seblovett/RGB_Clock/README.md

RGB_Clock
=========

A LED Clock

A contained PCB clock, with 60 RGB LEDs to display the time. 

Includes a noise sensor, LDR to adjust the brightness.
