seblovett/RGB_Clock/Schematics/SMPS_Design.ods

Sheet: Sheet1
Device | Voltage | Current | Count | Power
Atxmega | 3.3 | 1.50E-002 | 1 | 0.0495
LEDs | 3.3 | 0.1 | 60 | 19.8
PWM Controller | 3.3 | 1.00E-002 | 12 | 0.396
LM324 | 3.3 |  | 1 | 0
 |  |  |  | 20.2455
 |  |  |  | 4.0491

Sheet: Sheet2
Datasheet Constants
Vsw(bot) | 1.80E-01
t(on)(min) | 6.00E-08
Vsw(top) | 4.00E-01
t(off)(min) | 1.20E-07
Input
Vin min | 4.1734345909
Vin nom | 5
Vin max | 12
Output
Vout | 3.298
Iout (max) | 6
Iout (nom)
Feedback
Target Vout | 3.3
R2 | 1.00E+06
Target R1 | 2.40E+06
R1 | 2.40E+06
Vout | 3.298
Switching Frequency
Target Fsw | 1.00E+06
Rt (target) | 4.13E+01 | kOhm
Rt (actual) | 4.12E+01
Actual Fsw | 1.00E+06
Fsw(max) | 1.21E+07
Inductor
L(target) | 2.43E-06
Sx | 2.00E+05
L(min) | 2.34E-05
L(actual) | 3.20E-06
Ripple Current | 7.46E-01
Duty Cycle | 0.6596
Brown Out
Vin(en)(target) | 4.5
R4 | 1.00E+005
R3(target) | 3.50E+005
R3 | 3.50E+005
Vin(en) | 4.5
