seblovett/RGB_Clock/cad/Clock_Face.png

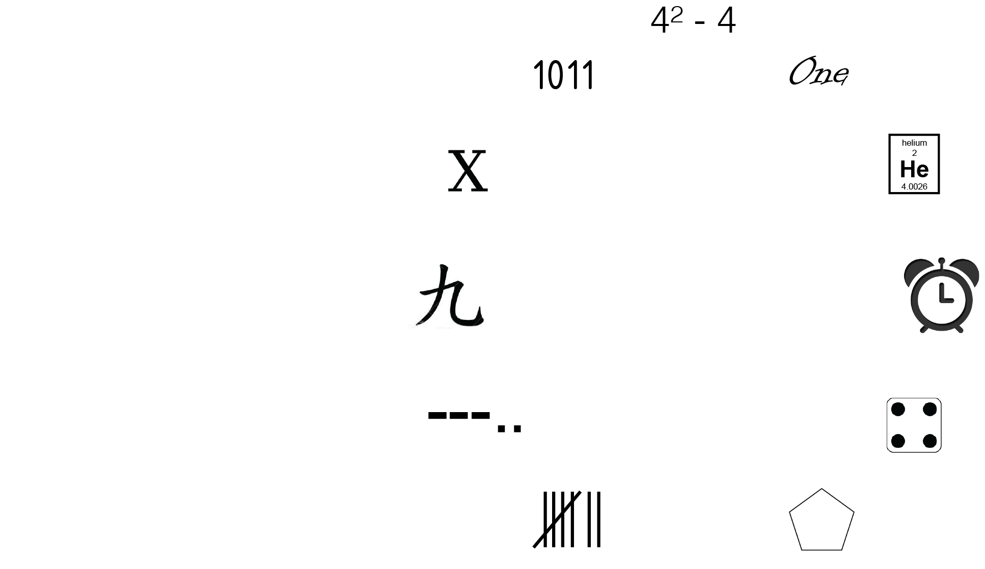
cad/Clock_Face.png
