seblovett/RGB_Clock/Schematics/BoM.ods

Reference | Value | Footprint | Datasheet | Part | Supplier |  | Price
CON2 | BARREL_JACK | Connect:JACK_ALIM | http://dlnmh9ip6v2uc.cloudfront.net/datasheets/Prototyping/18742.pdf | PRT-10811 | Farnell | 1 | 0.6 | 0.6
CON1 | USB-MICRO-B | Connect:USB_Mini-B |  |  | Stock | 1 |  | 0
X1 | 16MHz | Crystals_Oscillators_SMD:crystal_FA238-TSX3225 | http://www.farnell.com/datasheets/97450.pdf | ABM8-16.000MHZ-B2-T | Farnell | 1 | 1.25 | 1.25
IC1 | ATXMEGA256A3BU-A | Housings_QFP:TQFP-64_14x14mm_Pitch0.8mm |  | ATXMEGA256A3BU-A | Farnell | 1 | 5.41 | 5.41
U3 | PCA9685 | Housings_SSOP:TSSOP-28_4.4x9.7mm_Pitch0.65mm |  |  | Farnell | 12 | 1.34 | 16.08
D1 | LED | LEDs:LED-1206 |  |  | Farnell | 1 | 0.059 | 0.059
U13 | LT8612 | rgb:28QFN |  |  | LT | 1 |  | 0
BT1 | 3V | rgb:BU2032SM-HD-GTR-ND | http://www.memoryprotectiondevices.com/datasheets/BU2032SM-HD-G-datasheet.pdf | BU2032SM-HD-GTR-ND | Digikey | 1 | 0.59 | 0.59
J1 | AVR_JTAG_Header | rgb:FTSH-105-01-L-DV-K-A-P |  | FTSH-105-01-L-DV-K-A-P | Farnell | 1 | 1.41 | 1.41
LED11 | LED_RGB | rgb:rgbled1 |  | ASMT-YTD7-0AA02 | Farnell | 60 | 0.276 | 16.56
L1 | 3.2u | rgb:SD43 | http://www.coilcraft.com/pdfs/sd43.pdf | SD43-332ML | Coilcraft | 1 | 0.65 | 0.65
X2 | 32.768KhZ | rgb:SMD_Osc | http://www.abracon.com/Resonators/ABS06.pdf | ABS06-32.768KHZ-1-T | Farnell | 1 | 1.85 | 1.85
P1 | CONN_02X08 | Socket_Strips:Socket_Strip_Straight_2x08 |  |  | Stock | 1 |  | 0
SW1 | SW_PUSH |  | http://www.newark.com/pdfs/datasheets/spc/Ta-1143.pdf | MC32882 | Farnell | 4 | 0.173 | 0.692
 | PCB |  |  |  |  | 10 |  | 27
 |  |  |  | 37.41
 |  |  |  | 17.25 |  | 478.51
