seblovett/RGB_Clock/cad/jtag2.stl

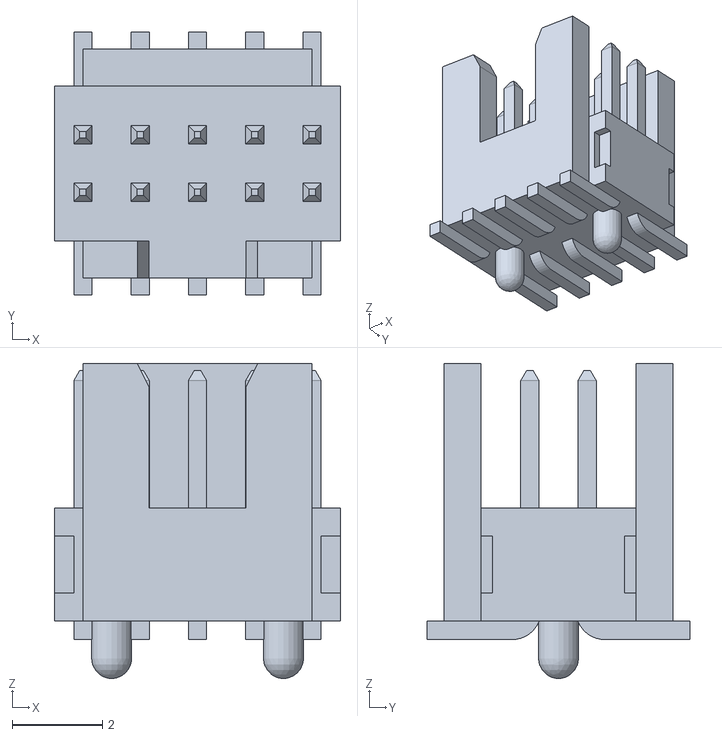
[picture p2: CAD file, 2015-01-14]
cad/jtag2.stl
6.35 x 5.84 x 6.99
