seblovett/RGB_Clock/cad/microusb2.stl

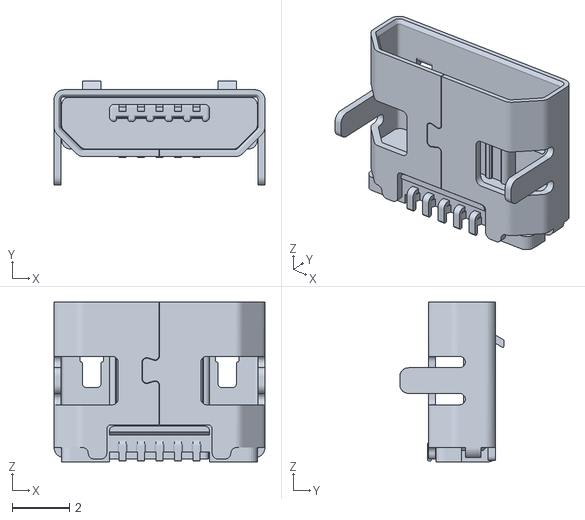
[picture p3: CAD file, 2015-01-14]
cad/microusb2.stl
7.40 x 3.66 x 5.60
