seblovett/RGB_Clock/cad/bu2032sm-hd-g_component.stl

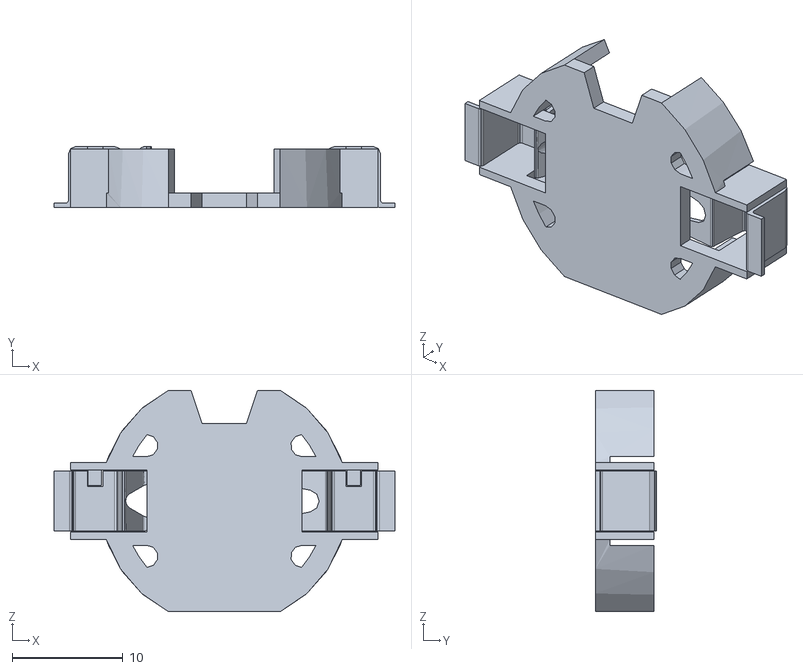
[picture p4: CAD file, 2015-01-14]
cad/bu2032sm-hd-g_component.stl
30.8 x 5.53 x 20.0
