seblovett/RGB_Clock/cad/rgb2.stl.stl

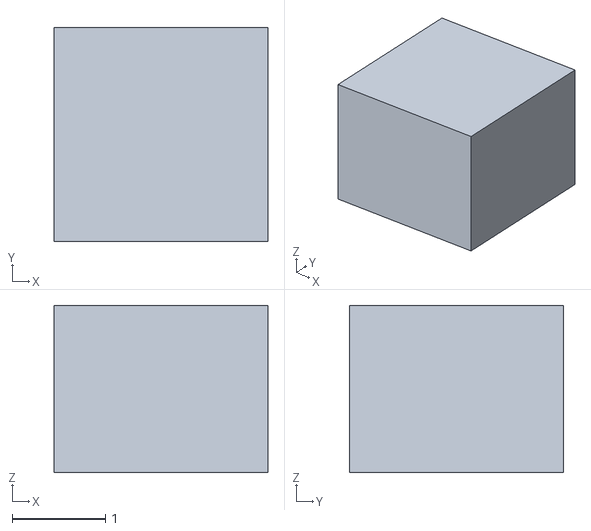
[picture p5: CAD file, 2015-01-14]
cad/rgb2.stl.stl
2.30 x 2.30 x 1.80
