seblovett/RGB_Clock/cad/rgb2.stl

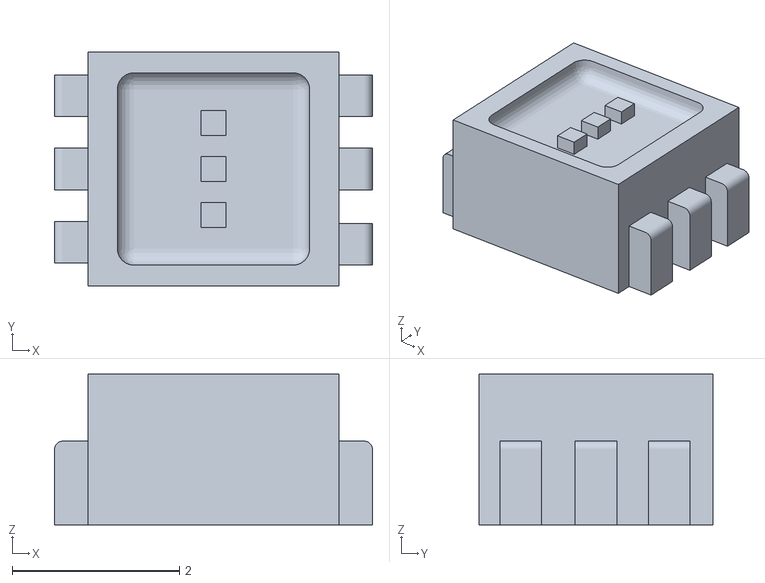
[picture p6: CAD file, 2015-01-10]
cad/rgb2.stl
3.80 x 2.80 x 1.80
