seblovett/RGB_Clock/(list of files, cad)

Other CAD files:
cad/jtag.fcstd
cad/batt.stl
cad/batt2.stl.stl
cad/microusb.stl
cad/RGBLED.fcstd
cad/rgb.stl
cad/jtag.stl
