seblovett/RGB_Clock/(threads)

Thread 3 (2015-01-28):

Add Power In connector

seblovett, 2015-01-28:
Add a power in connector and circuitry. Power in for voltages higher than 5V for more current

Closed 2015-01-28.

Thread 7 (2015-01-28):

Interface

seblovett, 2015-01-28:
Add some form of interface.
Capacitive sensors would be ideal, but KiCAD doesn't currently support arbitrary copper shapes. Some simple tac buttons will have to suffice.

Closed 2015-01-28.

Thread 8 (2015-02-08):

Reroute I2C

seblovett, 2015-02-08:
Re route I2C nets to closer to the edge. This is to improve the ground return path from the LED drivers.

Closed 2015-02-09.
