seblovett/RGB_Clock/Schematics/Display_Sub.kicad_pcb

## KiCad design Schematics/Display_Sub.kicad_pcb (2015-04-05)

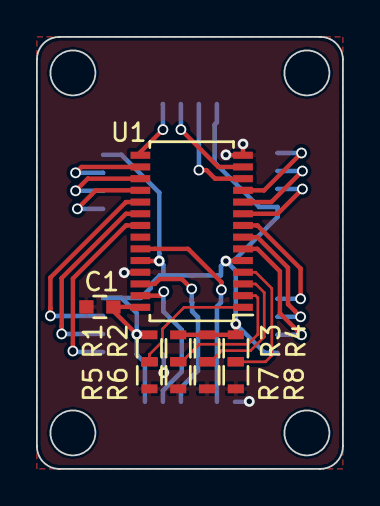
[picture p7: board Display_Sub.kicad_pcb from above]

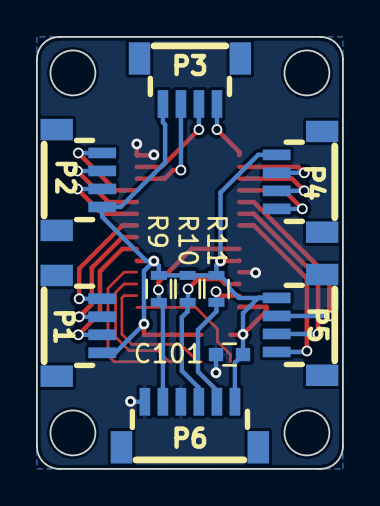
[picture p8: board Display_Sub.kicad_pcb from below]

Board: 2 copper layers, 17.0 x 24.0 mm, 20 parts (10 on the bottom side), 24 nets.

Parts:
C1, C101: C; C_0603
P1, P2, P3, P4, P5: CONN_01X04; JST-BM-04B-SRSS-TB
P6: CONN_01X06; JST-BM-06B-SRSS-TB
R1, R2, R3, R4, R5, R6, R7, R8: 0R; R_0603
R9, R10, R11: 10k; R_0603
U1: PCA9685; TSSOP-28_4.4x9.7mm_Pitch0.65mm

Connections:
/ID0: R1.2, R5.1, U1.1
/ID1: R2.2, R6.1, U1.2
/ID2: R3.2, R7.1, U1.3
/ID3: R4.2, R8.1, U1.4
/SCL: P6.3, R10.2, U1.26
/SDA: P6.2, R11.2, U1.27
/~OE: P6.5, R9.2, U1.23
GND: C1.2, C101.2, P6.4, P6.6, R5.2, R6.2, R7.2, R8.2, U1.14, U1.25
unnamed: P1.2, U1.6
unnamed: P1.3, U1.7
unnamed: P1.4, U1.8
unnamed: P2.2, U1.9
unnamed: P2.3, U1.10
unnamed: P2.4, U1.11
unnamed: P3.2, U1.12
unnamed: P3.3, U1.13
unnamed: P3.4, U1.15
unnamed: P4.2, U1.16
unnamed: P4.3, U1.17
unnamed: P4.4, U1.18
unnamed: P5.2, U1.19
unnamed: P5.3, U1.20
unnamed: P5.4, U1.21
VPP: C1.1, C101.1, P1.1, P2.1, P3.1, P4.1, P5.1, P6.1, R1.1, R2.1, R3.1, R4.1, R9.1, R10.1, R11.1, U1.5, U1.24, U1.28
