seblovett/RGB_Clock/Schematics/Root.kicad_pcb

## KiCad design Schematics/Root.kicad_pcb (2015-04-05)

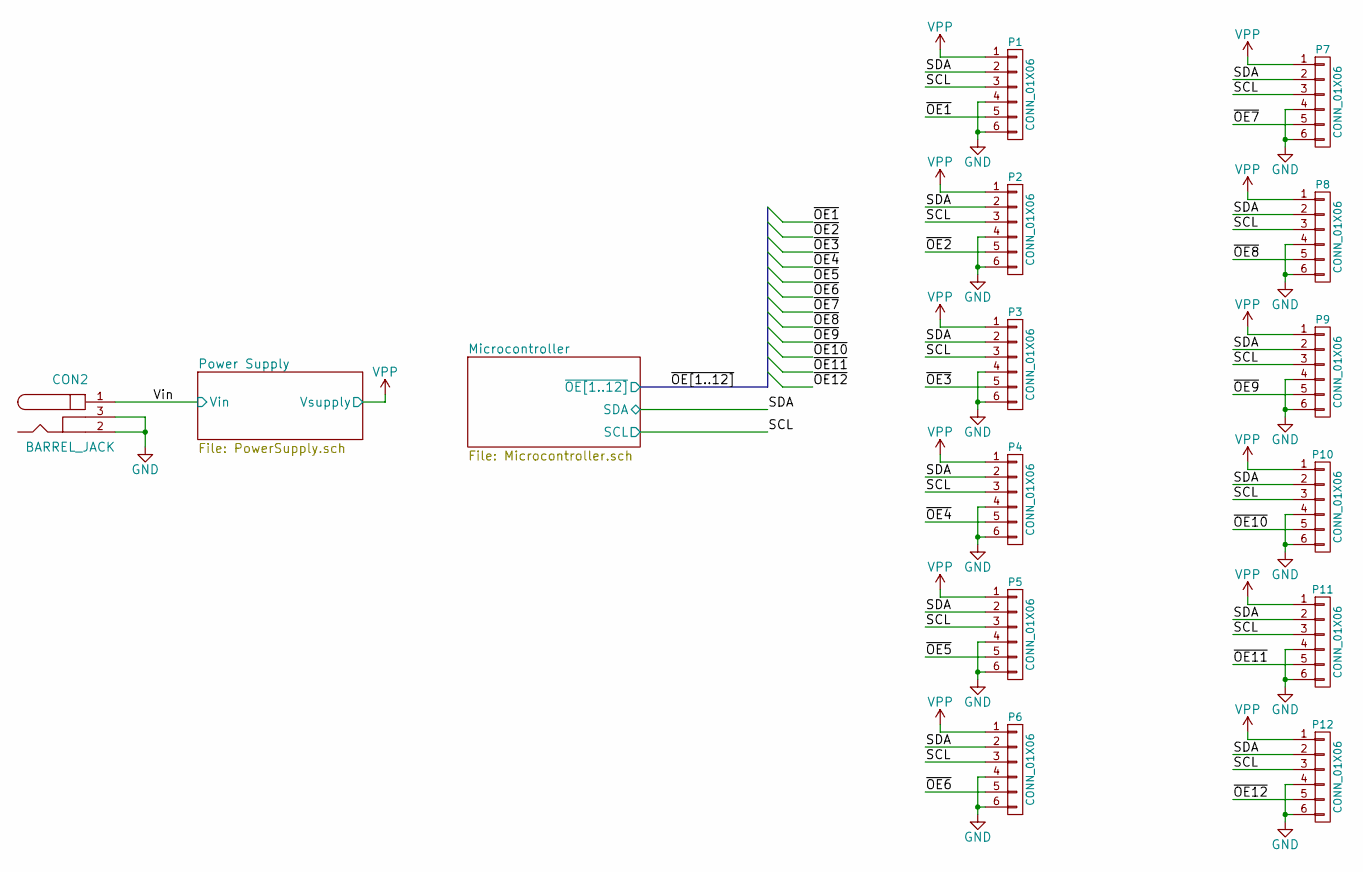
[picture p9: schematic Root.sch, RGB Clock]

Parts:
CON2: BARREL_JACK; JACK_ALIM; Part PRT-10811
P1, P2, P3, P4, P5, P6, P7, P8, P9, P10, P11, P12: CONN_01X06

Connections:
/Microcontroller/SCL: P1.3, P2.3, P3.3, P4.3, P5.3, P6.3, P7.3, P8.3, P9.3, P10.3, P11.3, P12.3; also elsewhere on the board
/Microcontroller/SDA: P1.2, P2.2, P3.2, P4.2, P5.2, P6.2, P7.2, P8.2, P9.2, P10.2, P11.2, P12.2; also elsewhere on the board
/Power Supply/Vin: CON2.1; also elsewhere on the board
/~OE1: P1.5; also elsewhere on the board
/~OE2: P2.5; also elsewhere on the board
/~OE3: P3.5; also elsewhere on the board
/~OE4: P4.5; also elsewhere on the board
/~OE5: P5.5; also elsewhere on the board
/~OE6: P6.5; also elsewhere on the board
/~OE7: P7.5; also elsewhere on the board
/~OE8: P8.5; also elsewhere on the board
/~OE9: P9.5; also elsewhere on the board
/~OE10: P10.5; also elsewhere on the board
/~OE11: P11.5; also elsewhere on the board
/~OE12: P12.5; also elsewhere on the board
GND: CON2.2, CON2.3, P1.4, P1.6, P2.4, P2.6, P3.4, P3.6, P4.4, P4.6, P5.4, P5.6, P6.4, P6.6, P7.4, P7.6, P8.4, P8.6, P9.4, P9.6, P10.4, P10.6, P11.4, P11.6, P12.4, P12.6; also elsewhere on the board
VPP: P1.1, P2.1, P3.1, P4.1, P5.1, P6.1, P7.1, P8.1, P9.1, P10.1, P11.1, P12.1; also elsewhere on the board

Schematic: Microcontroller.sch

Parts:
BT1: 3V; BU2032SM-HD-GTR-ND; Part BU2032SM-HD-GTR-ND
C10, C12: 33pF; C_0603
C11, C13: 22pF; C_0603
C14: 1u; C_0603
C15, C16, C17, C18, C19: 100n; C_0603
CON1: USB-MICRO-B; USB_Mini-B
IC1: ATXMEGA256A3BU-A; TQFP-64_14x14mm_Pitch0.8mm; Part ATXMEGA256A3BU-A
J1: AVR_JTAG_Header; FTSH-105-01-L-DV-K-A-P; Part FTSH-105-01-L-DV-K-A-P
JP1, JP2, JP3: JUMPER; R_0603
P13, P14: CONN_01X02; Pin_Header_Straight_1x02
R15: 100R; R_0603
R17, R18: 47k; R_0603
R100: 100k; R_0603
SW1, SW2: SW_PUSH; SW; Part MC32882
X1: 16MHz; crystal_FA238-TSX3225; Part ABM8-16.000MHZ-B2-T
X2: 32.768KhZ; SMD_Osc; Part ABS06-32.768KHZ-1-T

Connections:
/Microcontroller/AVR_RXD: IC1.22 (MISO/RXD1/~OC0DLS~/PC6), P14.1
/Microcontroller/AVR_TXD: IC1.23 (EVOUT/CLKP/SCK/TXD1/OC0DHS/PC7), P14.2
/Microcontroller/JUMPER: IC1.38 (PE2/OC0C/RXD0), JP1.1, R100.2
/Microcontroller/SCL: IC1.17 (SCL/XCK0/OC0AHS/OC0B/PC1), R18.2; also elsewhere on the board
/Microcontroller/SDA: IC1.16 (SDA/~OC0ALS~/OC0A/PC0), R17.2; also elsewhere on the board
/Microcontroller/SW1: IC1.18 (SDAOUT/RXD0/~OC0BLS~/OC0C/PC2), SW1.1
/Microcontroller/SW2: IC1.1 (AC3/ADC11/ADC3/PA3), JP3.1
/Microcontroller/TCK: IC1.12 (TCK/AC1OUT/AC6/ADC6/ADC14/PB6), J1.1
/Microcontroller/TDI: IC1.11 (TDI/AC5/ADC5/ADC13/PB5), J1.9
/Microcontroller/TDO: IC1.13 (TDO/AC0OUT/AC7/ADC7/ADC15/PB7), J1.3
/Microcontroller/TMS: IC1.10 (TMS/AC4/ADC4/ADC12/PB4), J1.5
/Microcontroller/TOSC1: C11.1, IC1.43 (TOSC1), X2.1
/Microcontroller/TOSC2: C13.1, IC1.42 (TOSC2), X2.2
/Microcontroller/USB_D+: CON1.3 (D+), IC1.33 (EVOUT/CLKP/SCK/TXD1/D+/PD7)
/Microcontroller/USB_D-: CON1.2 (D-), IC1.32 (MISO/RXD1/D-/PD6)
/Microcontroller/~RESET: IC1.57 (~RESET~/PDI_CLK), J1.6, JP2.1
/~OE1: IC1.2 (AC4/ADC12/ADC4/PA4); also elsewhere on the board
/~OE2: IC1.64 (AC2/ADC10/ADC2/PA2); also elsewhere on the board
/~OE3: IC1.63 (AC1/ADC9/ADC1/PA1); also elsewhere on the board
/~OE4: IC1.62 (AREF/AC0/ADC8/ADC0/PA0); also elsewhere on the board
/~OE5: IC1.55 (PF7); also elsewhere on the board
/~OE6: IC1.39 (PE3/OC0D/TXD0); also elsewhere on the board
/~OE7: IC1.31 (MOSI/XCK1/OC1B/PD5); also elsewhere on the board
/~OE8: IC1.30 (~SS~/OC1A/PD4); also elsewhere on the board
/~OE9: IC1.29 (TXD0/OC0D/PD3); also elsewhere on the board
/~OE10: IC1.5 (AC0OUT/AC7/ADC15/ADC7/PA7); also elsewhere on the board
/~OE11: IC1.4 (AC1OUT/AC6/ADC14/ADC6/PA6); also elsewhere on the board
/~OE12: IC1.3 (AC5/ADC13/ADC5/PA5); also elsewhere on the board
GND: BT1.2, C10.2, C11.2, C12.2, C13.2, C14.2, C15.2, C16.2, C17.2, C18.2, C19.2, CON1.4 (ID), CON1.5 (GND), CON1.6 (SHELL1), CON1.7 (SHELL2), CON1.8 (SHELL3), CON1.9 (SHELL4), IC1.14 (GND), IC1.24 (GND), IC1.34 (GND), IC1.44 (GND), IC1.52 (GND), IC1.60 (GND), J1.2, J1.10, JP1.2, P13.2, SW1.2, SW2.2, X1.3 (case), X2.3 (case); also elsewhere on the board
unnamed: BT1.1, R15.2
unnamed: C10.1, IC1.58 (PR0/XTAL2), X1.1
unnamed: C12.1, IC1.59 (PR1/XTAL1), X1.2
unnamed: IC1.51 (VBAT), R15.1
unnamed: JP2.2, JP3.2, SW2.1
VPP: C14.1, C15.1, C16.1, C17.1, C18.1, C19.1, IC1.15 (VCC), IC1.25 (VCC), IC1.35 (VCC), IC1.45 (VCC), IC1.53 (VCC), IC1.61 (AVCC), J1.4, P13.1, R17.1, R18.1, R100.1; also elsewhere on the board

Notes on the sheet:
Load capacitance of OSC pins = 3pF

Schematic: PowerSupply.sch

Parts:
C33: 10u; C_0603
C34: 10n; C_0402
C35: 1u; C_0402
C36: 100n; C_0402
C37: 10p; C_0402
C38: 47n; C_0603
C39: 47n; C_0603; Part Murata
D1: LED; LED-1206
L1: 3.2u; SD43; Part SD43-332ML
R31: 220R; R_0603
R32: 41.2k; R_0402
R33: 2.4M; R_0402
R34: 1M; R_0402
U13: LT8612; 28QFN

Connections:
/Power Supply/BST: C36.2, U13.20
/Power Supply/FB: C37.2, R33.2, R34.1, U13.24
/Power Supply/IntVcc: C35.1, U13.21
/Power Supply/PG: R31.2, U13.23
/Power Supply/Rt: R32.1, U13.3
/Power Supply/SS: C34.1, U13.2
/Power Supply/SW: C36.1, L1.1, U13.15, U13.16, U13.17, U13.18, U13.19
/Power Supply/Vin: C33.1, U13.4, U13.5, U13.6, U13.7; also elsewhere on the board
GND: C33.2, C34.2, C35.2, C38.2, C39.2, R32.2, R34.2, U13.1, U13.8, U13.9, U13.10, U13.11, U13.12, U13.13, U13.14, U13.25, U13.26, U13.27, U13.28, U13.29; also elsewhere on the board
unnamed: D1.2 (K), R31.1
VPP: C37.1, C38.1, C39.1, D1.1 (A), L1.2, R33.1, U13.22; also elsewhere on the board

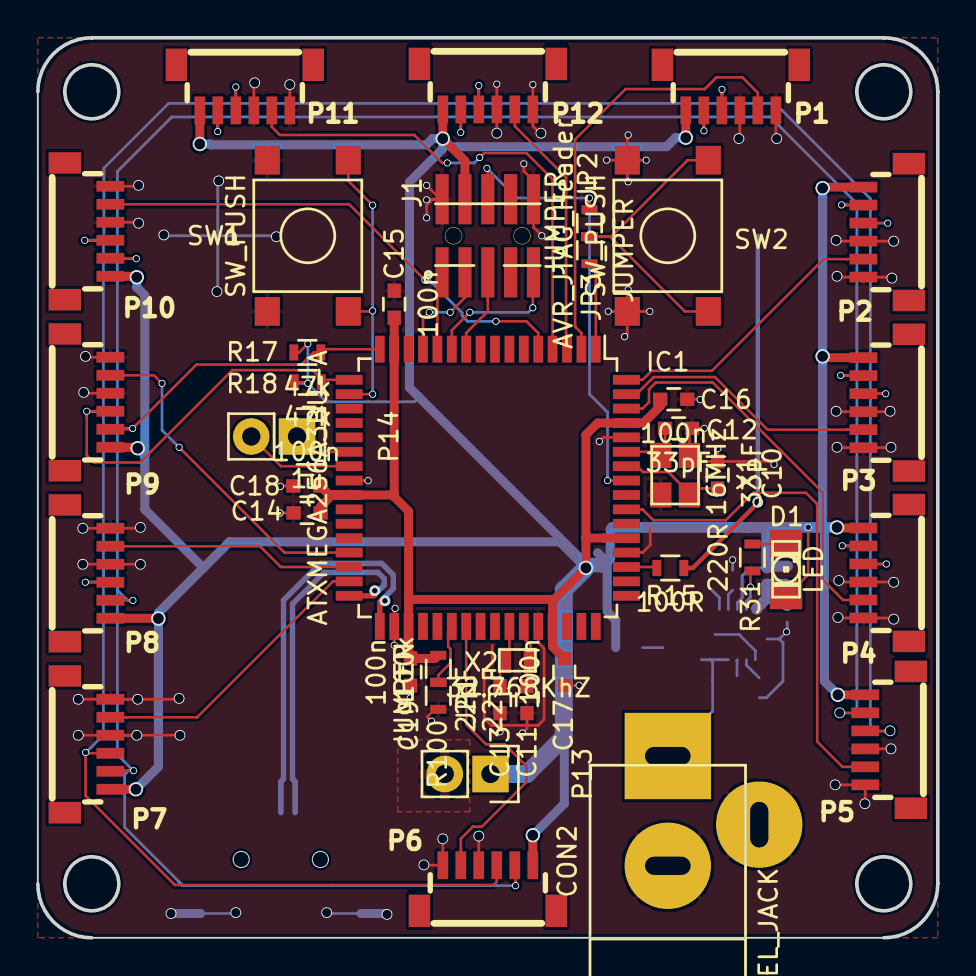
[picture p10: board Root.kicad_pcb from above]

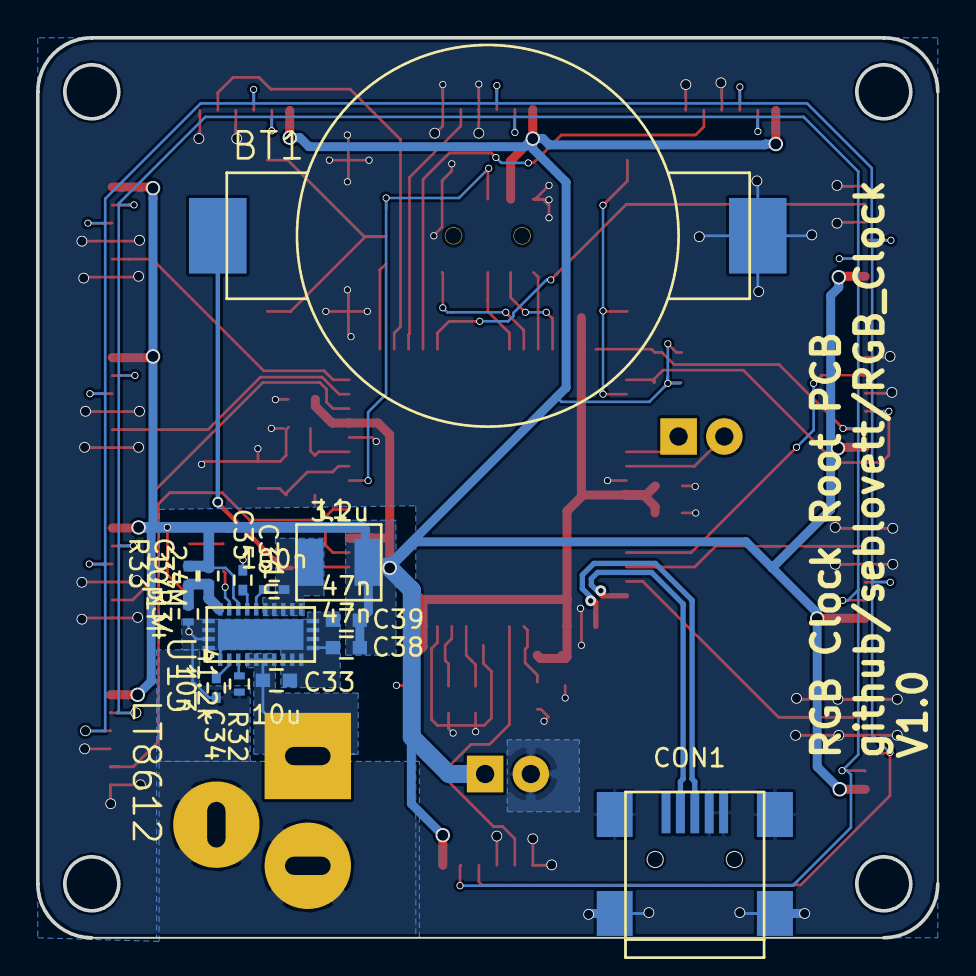
[picture p11: board Root.kicad_pcb from below]

Board: 2 copper layers, 50.0 x 50.0 mm, 54 parts (14 on the bottom side), 44 nets.
