seblovett/RGB_Clock/(commit log)

2014-12-29 Added base design. Much to do!
    [Clock.brd, Clock.sch]
2014-12-29 Some useful tings to generate long commands for placing LEDs in the right place
    [LED_Locations.ods]
2014-12-30 connected all PWM and LEDs.
    [Clock.brd, Clock.sch]
2014-12-30 Probably joined with last commit..
    [Clock.brd, Clock.sch]
2015-01-10 Redone schematics in KiCAD.
    Need to sort out ref des' for LEDs and PWM drivers and then can begin some layout!
    [BPF.sch, Display.sch, Display_Sub.sch, Microcontroller.sch, PowerSupply.sch, RGBLED.fcstd, Root.kicad_pcb, Root.sch]
2015-01-10 LEDs are placed!
    Worked out how to script KiCAD to do it too. Winner winner, time for a chicken dinner
    [BPF.sch, Display_Sub.sch, Microcontroller.sch, Root.kicad_pcb]
2015-01-14 Latest schematics and pcb.
    [Display.sch, Display_Sub.sch, Microcontroller.sch, Root.kicad_pcb]
2015-01-14 Removed old EAGLE stuff.
    [Clock.brd, Clock.sch, LED_Locations.ods]
2015-01-14 Added all CAD files
    [batt.stl, batt2.stl.stl, bu2032sm-hd-g_component.stl, jtag.fcstd, jtag.stl, jtag2.stl, microusb.stl, microusb2.stl]
2015-01-14 Updated script. Moves the PWM ICs also
2015-01-14 Added schematic lib
2015-01-27 Updated schematics
    [BPF.sch, Display.sch, Display_Sub.sch, Microcontroller.sch, PowerSupply.sch, Root.sch]
2015-01-27 Removed RF. Placed all LED drivers and passives and begun routing
    [Display.sch, Display_Sub.sch, Microcontroller.sch, PowerSupply.sch, Root.kicad_pcb, Root.sch]
2015-01-28 Added power in connector in schematics. #3
    [Display.sch, Display_Sub.sch, Microcontroller.sch, PowerSupply.sch, Root.sch]
2015-01-28 Added some switches for interface #7
    [Microcontroller.sch, Root.sch]
2015-01-28 Changed lots
    Finalised the Inductor. Closes #5
    Changed USB Connector. Closes #4
    Added four switches for a simple interface. Closes #7
    Added a power jack. Closes #3
    Found RTC Oscillator. Closes #1.
    Added part numbers to all major components. Closes #2
    [Display.sch, Display_Sub.sch, Microcontroller.sch, PowerSupply.sch, Root.kicad_pcb, Root.sch]
2015-01-29 Ammended a net. Done a lot of routing
    [Microcontroller.sch, PowerSupply.sch, Root.kicad_pcb]
2015-01-30 Done lots of routing. Mostly done.
    Rearranged some connections to make routing easier.
    Need to check unconnected nets.
    [Display_Sub.sch, Microcontroller.sch, Root.kicad_pcb]
2015-02-01 Main GND plane added.
    Need to add island plane for SMPS
    [Root.kicad_pcb]
2015-02-01 Sorted SMPS ground plane
    [Root.kicad_pcb]
2015-02-01 Sorted silkscreen out. Added a select to change function of one of the switches to between a reset or a general purpose
    [Microcontroller.sch, Root.kicad_pcb]
2015-02-01 Added SMPS related things
    [SMPS_Design.ods]
2015-02-01 Added clock face to silkscreen
    [Root.kicad_pcb]
2015-02-09 Completed layout of 10cm board. Fixes #8
    [Display.sch, Display_Sub.sch, Microcontroller.sch, PowerSupply.sch, Root.kicad_pcb, Root.sch]
2015-02-09 Added BoM with costings.
    Also added schematic and layout review
    [BoM.ods]
2015-03-23 Started Redesign.
    [Clock_10cm.kicad_pcb, Display_Sub.sch, Microcontroller.sch, PowerSupply.sch, Root.kicad_pcb, Root.sch]
2015-03-25 Done some more layout.
    Need to sort pin swaps for the OE lines and complete routing
    [Microcontroller.sch, Root.kicad_pcb, Root.sch]
2015-04-03 Split design into two modules
    [Display_Sub.kicad_pcb, Display_Sub.sch, Microcontroller.sch, PowerSupply.sch, Root.kicad_pcb]
2015-04-05 Added some debug headers for power and UART
    Added silkscreen info also.
    [Microcontroller.sch, PowerSupply.sch, Root.kicad_pcb, Root.sch]
2015-04-05 Sorted silkscreen out and panelized design.
    [Display_Sub.kicad_pcb, Microcontroller.sch, PowerSupply.sch, Root.sch, panelized.kicad_pcb]
